MatthewATaylor/DigiDrum3000/pcb/pcb.kicad_pcb

## KiCad design pcb/pcb.kicad_pcb (2025-11-11)

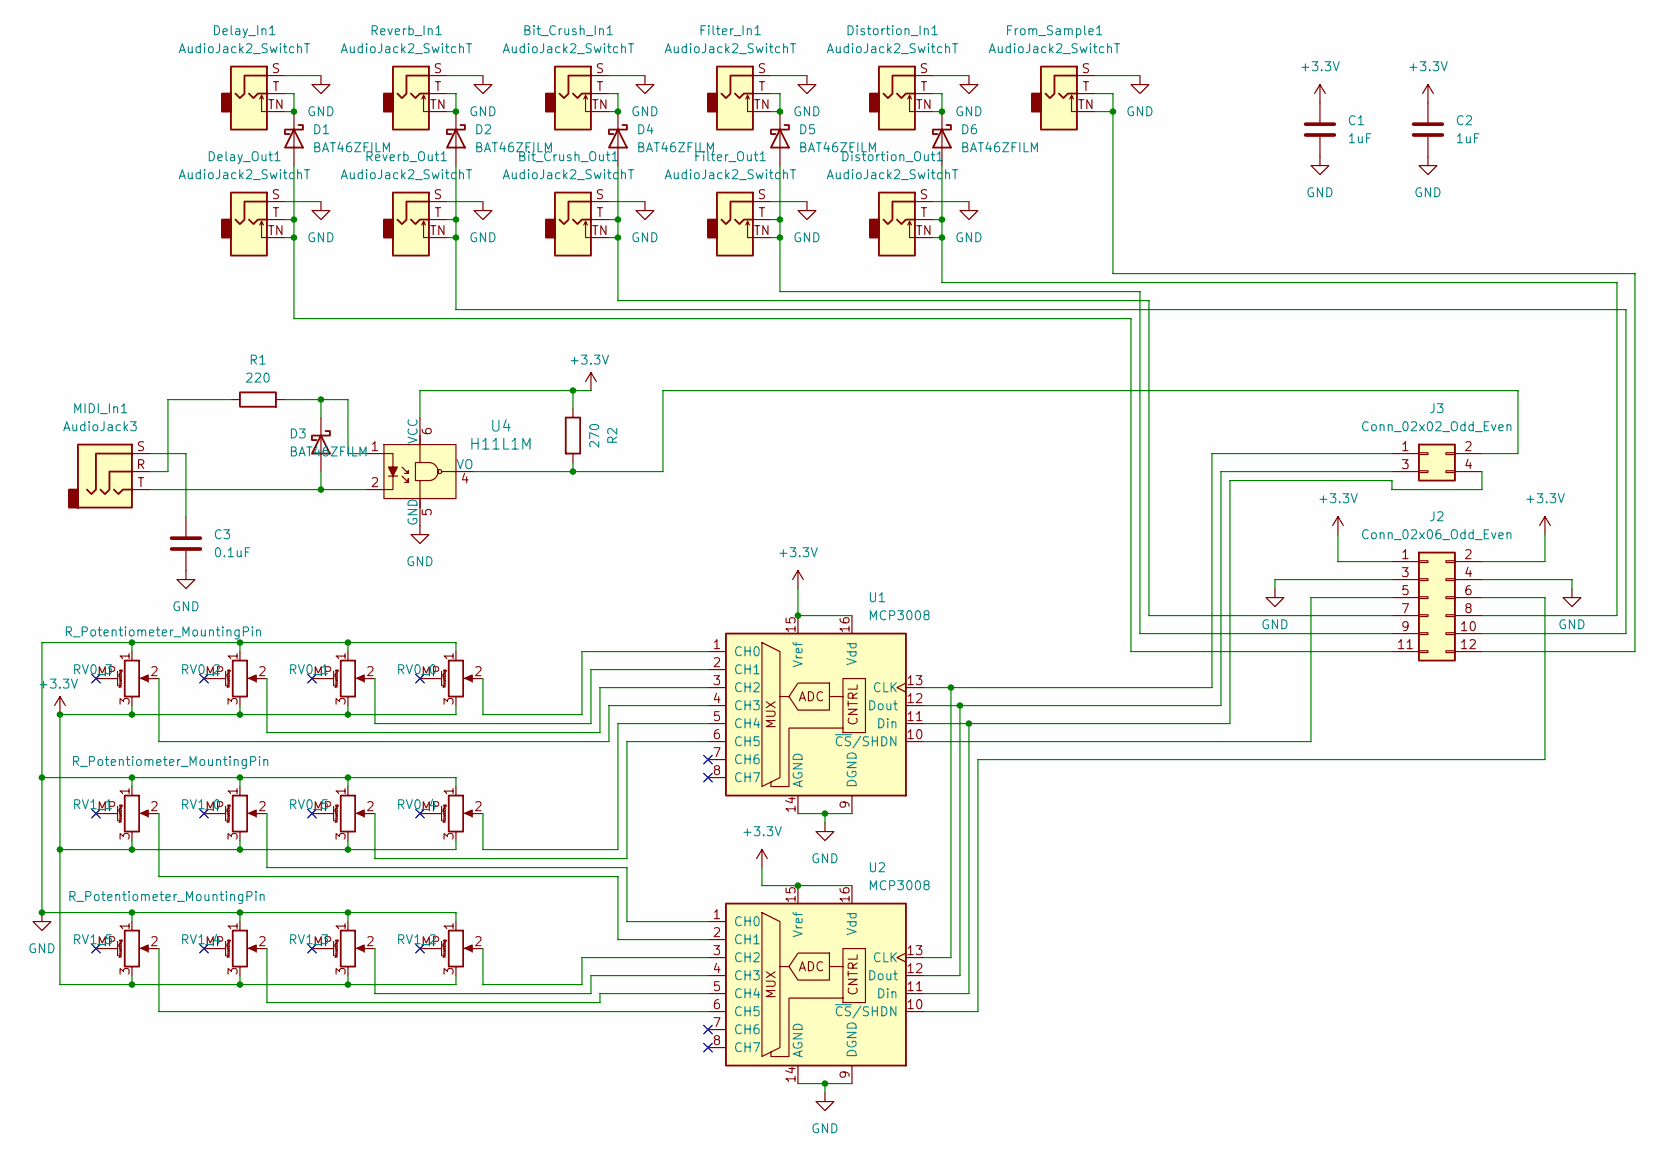
[picture p1: schematic pcb.kicad_sch, Drum Machine PCB]

Parts:
Bit_Crush_In1: AudioJack2_SwitchT; Jack_3.5mm_QingPu_WQP-PJ398SM_Vertical_CircularHoles
Bit_Crush_Out1: AudioJack2_SwitchT; Jack_3.5mm_QingPu_WQP-PJ398SM_Vertical_CircularHoles
C1, C2: 1uF; 0805
C3: 0.1uF; 0805
D1, D2, D3, D4, D5, D6: BAT46ZFILM; D_SOD-123
Delay_In1: AudioJack2_SwitchT; Jack_3.5mm_QingPu_WQP-PJ398SM_Vertical_CircularHoles
Delay_Out1: AudioJack2_SwitchT; Jack_3.5mm_QingPu_WQP-PJ398SM_Vertical_CircularHoles
Distortion_In1: AudioJack2_SwitchT; Jack_3.5mm_QingPu_WQP-PJ398SM_Vertical_CircularHoles
Distortion_Out1: AudioJack2_SwitchT; Jack_3.5mm_QingPu_WQP-PJ398SM_Vertical_CircularHoles
Filter_In1: AudioJack2_SwitchT; Jack_3.5mm_QingPu_WQP-PJ398SM_Vertical_CircularHoles
Filter_Out1: AudioJack2_SwitchT; Jack_3.5mm_QingPu_WQP-PJ398SM_Vertical_CircularHoles
From_Sample1: AudioJack2_SwitchT; Jack_3.5mm_QingPu_WQP-PJ398SM_Vertical_CircularHoles
J2: Conn_02x06_Odd_Even; PinHeader_2x06_P2.54mm_Horizontal
J3: Conn_02x02_Odd_Even; PinHeader_2x02_P2.54mm_Horizontal
MIDI_In1: AudioJack3; Jack_3.5mm_QingPu_WQP-PJ366ST_Vertical_CircularHoles
R1: 220; 0805
R2: 270; 0805
RV0_0, RV0_1, RV0_2, RV0_3, RV0_4, RV0_5, RV1_0, RV1_1, RV1_2, RV1_3, RV1_4, RV1_5: R_Potentiometer_MountingPin; Potentiometer_Alpha_RD901F-40-00D_Single_Vertical_MP
Reverb_In1: AudioJack2_SwitchT; Jack_3.5mm_QingPu_WQP-PJ398SM_Vertical_CircularHoles
Reverb_Out1: AudioJack2_SwitchT; Jack_3.5mm_QingPu_WQP-PJ398SM_Vertical_CircularHoles
U1, U2: MCP3008; SOIC-16_W3.90mm
U4: H11L1M; DIP-6_W7.62mm; MPN H11L1M; Digi-Key_PN H11L1-MQT-ND

Connections:
+3.3V: C1.1, C2.1, J2.1, J2.2, R2.1, RV0_0.3, RV0_1.3, RV0_2.3, RV0_3.3, RV0_4.3, RV0_5.3, RV1_0.3, RV1_1.3, RV1_2.3, RV1_3.3, RV1_4.3, RV1_5.3, U1.15 (Vref), U1.16 (Vdd), U2.15 (Vref), U2.16 (Vdd), U4.6 (VCC)
GND: Bit_Crush_In1.S, Bit_Crush_Out1.S, C1.2, C2.2, C3.2, Delay_In1.S, Delay_Out1.S, Distortion_In1.S, Distortion_Out1.S, Filter_In1.S, Filter_Out1.S, From_Sample1.S, J2.3, J2.4, RV0_0.1, RV0_1.1, RV0_2.1, RV0_3.1, RV0_4.1, RV0_5.1, RV1_0.1, RV1_1.1, RV1_2.1, RV1_3.1, RV1_4.1, RV1_5.1, Reverb_In1.S, Reverb_Out1.S, U1.9 (DGND), U1.14 (AGND), U2.9 (DGND), U2.14 (AGND), U4.5 (GND)
unnamed: C3.1, MIDI_In1.S
unnamed: D1.2 (A), Delay_Out1.T, Delay_Out1.TN, J2.11
unnamed: D1.1 (K), Delay_In1.T, Delay_In1.TN
unnamed: D2.2 (A), J2.10, Reverb_Out1.T, Reverb_Out1.TN
unnamed: D2.1 (K), Reverb_In1.T, Reverb_In1.TN
unnamed: D3.2 (A), MIDI_In1.T, U4.2
unnamed: D3.1 (K), R1.2, U4.1
unnamed: Bit_Crush_Out1.T, Bit_Crush_Out1.TN, D4.2 (A), J2.7
unnamed: Bit_Crush_In1.T, Bit_Crush_In1.TN, D4.1 (K)
unnamed: D5.2 (A), Filter_Out1.T, Filter_Out1.TN, J2.9
unnamed: D5.1 (K), Filter_In1.T, Filter_In1.TN
unnamed: D6.2 (A), Distortion_Out1.T, Distortion_Out1.TN, J2.8
unnamed: D6.1 (K), Distortion_In1.T, Distortion_In1.TN
unnamed: J2.5, U1.10 (~CS/SHDN)
unnamed: J2.6, U2.10 (~CS/SHDN)
unnamed: From_Sample1.T, From_Sample1.TN, J2.12
unnamed: J3.1, U1.13 (CLK), U2.13 (CLK)
unnamed: J3.2, R2.2, U4.4 (VO)
unnamed: J3.3, U1.12 (Dout), U2.12 (Dout)
unnamed: J3.4, U1.11 (Din), U2.11 (Din)
unnamed: MIDI_In1.R, R1.1
unnamed: RV0_0.2, U1.1 (CH0)
unnamed: RV0_1.2, U1.2 (CH1)
unnamed: RV0_2.2, U1.3 (CH2)
unnamed: RV0_3.2, U1.4 (CH3)
unnamed: RV0_4.2, U1.5 (CH4)
unnamed: RV0_5.2, U1.6 (CH5)
unnamed: RV1_0.2, U2.1 (CH0)
unnamed: RV1_1.2, U2.2 (CH1)
unnamed: RV1_2.2, U2.3 (CH2)
unnamed: RV1_3.2, U2.4 (CH3)
unnamed: RV1_4.2, U2.5 (CH4)
unnamed: RV1_5.2, U2.6 (CH5)

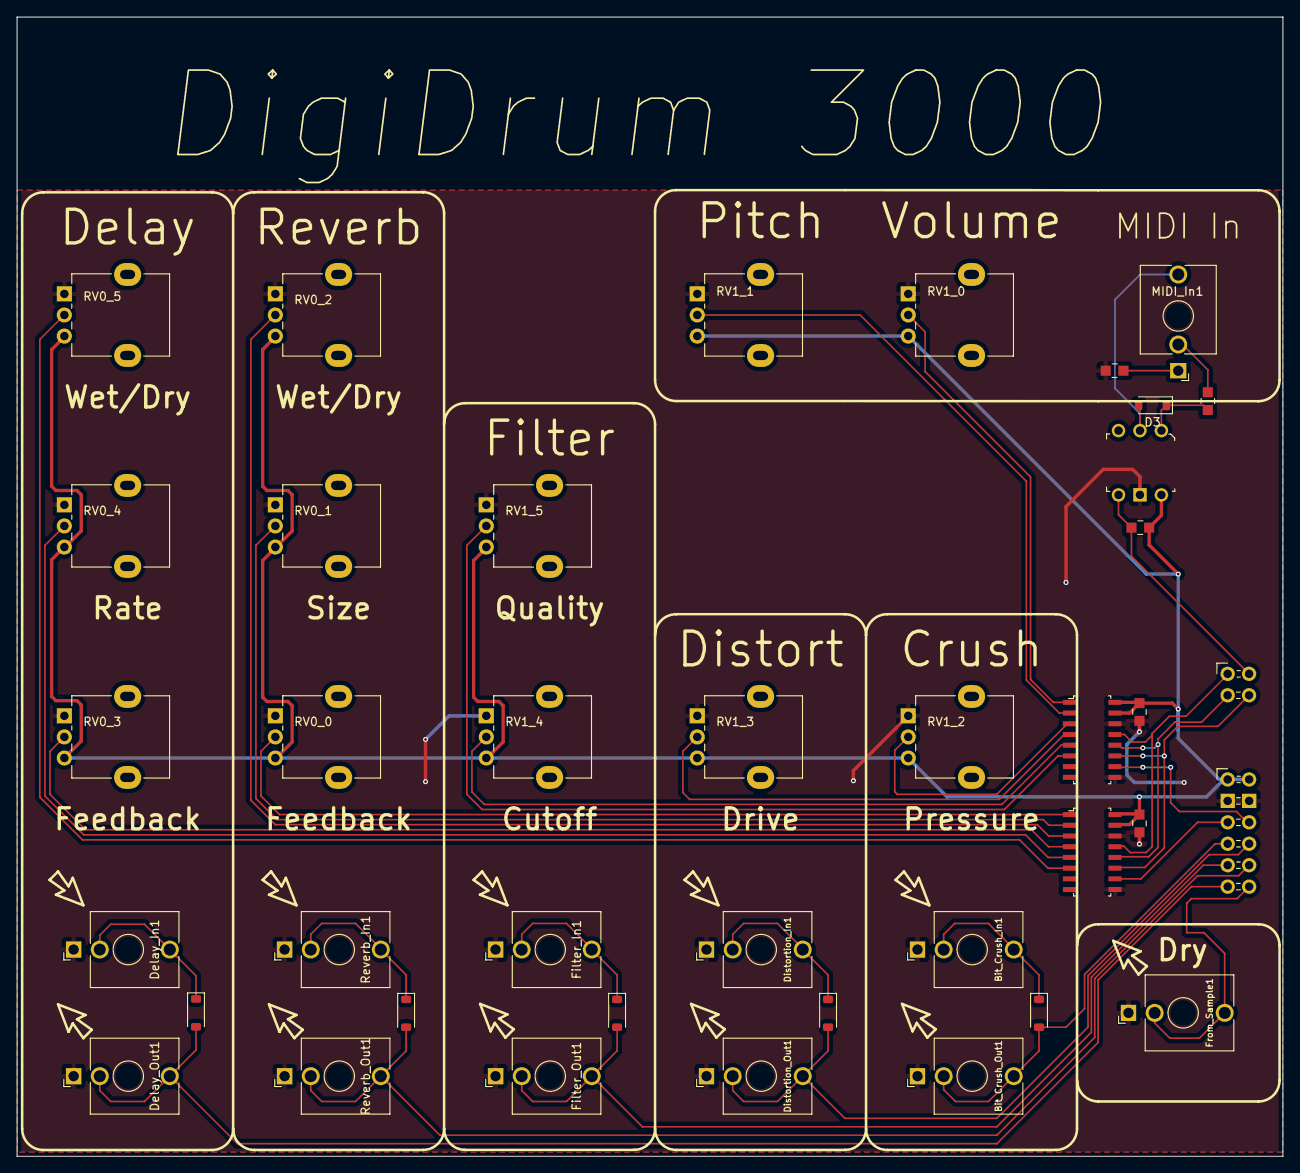
[picture p2: board pcb.kicad_pcb from above]

Board: 2 copper layers, 150.0 x 135.0 mm, 40 parts (0 on the bottom side), 35 nets.
