MatthewATaylor/DigiDrum3000/hdl/video_processor.sv

`timescale 1ns / 1ps  //
`default_nettype none

module video_processor #(
    parameter INSTRUMENT_COUNT = 3
) (
    input wire clk_100MHz,
    input wire clk_pixel,
    input wire rst,

    // clk_100MHz
    //input wire [15:0] instrument_samples[INSTRUMENT_COUNT-1:0],
    input wire midi_valid,
    input wire [6:0] midi_key,
    input wire [6:0] midi_velocity,
    //input wire [15:0] upsampled_audio_ouput,
    input wire [9:0] volume_on_clk,
    input wire [9:0] pitch_on_clk,
    input wire [9:0] delay_wet_on_clk,
    input wire [9:0] delay_rate_on_clk,
    input wire [9:0] delay_feedback_on_clk,
    input wire [9:0] reverb_wet_on_clk,
    input wire [9:0] reverb_size_on_clk,
    input wire [9:0] reverb_feedback_on_clk,
    input wire [9:0] filter_quality_on_clk,
    input wire [9:0] filter_cutoff_on_clk,
    input wire [9:0] distortion_drive_on_clk,
    input wire [9:0] crush_pressure_on_clk,

    input wire [2:0] output_src_on_clk,
    input wire [2:0] crush_src_on_clk,
    input wire [2:0] distortion_src_on_clk,
    input wire [2:0] filter_src_on_clk,
    input wire [2:0] reverb_src_on_clk,
    input wire [2:0] delay_src_on_clk,

    input wire delay_rate_fast_on_clk,

    // clk_pixel
    input  wire  [15:0] dram_read_data,
    output logic        dram_read_active_draw,
    output logic [10:0] dram_read_h_count,
    output logic [ 9:0] dram_read_v_count,

    output logic [15:0] dram_write_data,
    output logic        dram_write_valid,
    output logic        dram_write_last,

    output logic [23:0] pixel_to_hdmi,
    output logic        active_draw_to_hdmi,
    output logic        v_sync_to_hdmi,
    output logic        h_sync_to_hdmi
);
  logic [ 9:0] volume_on_pixel_clk;
  logic [ 9:0] pitch_on_pixel_clk;
  logic [ 9:0] delay_wet_on_pixel_clk;
  logic [ 9:0] delay_rate_on_pixel_clk;
  logic [ 9:0] delay_feedback_on_pixel_clk;
  logic [ 9:0] reverb_wet_on_pixel_clk;
  logic [ 9:0] reverb_size_on_pixel_clk;
  logic [ 9:0] reverb_feedback_on_pixel_clk;
  logic [ 9:0] filter_quality_on_pixel_clk;
  logic [ 9:0] filter_cutoff_on_pixel_clk;
  logic [ 9:0] distortion_drive_on_pixel_clk;
  logic [ 9:0] crush_pressure_on_pixel_clk;

  logic [ 2:0] output_src_on_pixel_clk;
  logic [ 2:0] crush_src_on_pixel_clk;
  logic [ 2:0] distortion_src_on_pixel_clk;
  logic [ 2:0] filter_src_on_pixel_clk;
  logic [ 2:0] reverb_src_on_pixel_clk;
  logic [ 2:0] delay_src_on_pixel_clk;

  logic        delay_rate_fast_on_pixel_clk;

  logic [10:0] sig_gen_h_count;
  logic [ 9:0] sig_gen_v_count;
  logic        sig_gen_active_draw;
  logic        sig_gen_new_frame;

  clk_cross_buffer my_buf (
      .clk_pixel(clk_pixel),
      .rst      (rst),
      .new_frame(sig_gen_new_frame),

      .volume_on_clk          (volume_on_clk),
      .pitch_on_clk           (pitch_on_clk),
      .delay_wet_on_clk       (delay_wet_on_clk),
      .delay_rate_on_clk      (delay_rate_on_clk),
      .delay_feedback_on_clk  (delay_feedback_on_clk),
      .reverb_wet_on_clk      (reverb_wet_on_clk),
      .reverb_size_on_clk     (reverb_size_on_clk),
      .reverb_feedback_on_clk (reverb_feedback_on_clk),
      .filter_quality_on_clk  (filter_quality_on_clk),
      .filter_cutoff_on_clk   (filter_cutoff_on_clk),
      .distortion_drive_on_clk(distortion_drive_on_clk),
      .crush_pressure_on_clk  (crush_pressure_on_clk),

      .output_src_on_clk    (output_src_on_clk),
      .crush_src_on_clk     (crush_src_on_clk),
      .distortion_src_on_clk(distortion_src_on_clk),
      .filter_src_on_clk    (filter_src_on_clk),
      .reverb_src_on_clk    (reverb_src_on_clk),
      .delay_src_on_clk     (delay_src_on_clk),

      .delay_rate_fast_on_clk(delay_rate_fast_on_clk),

      .volume_on_pixel_clk          (volume_on_pixel_clk),
      .pitch_on_pixel_clk           (pitch_on_pixel_clk),
      .delay_wet_on_pixel_clk       (delay_wet_on_pixel_clk),
      .delay_rate_on_pixel_clk      (delay_rate_on_pixel_clk),
      .delay_feedback_on_pixel_clk  (delay_feedback_on_pixel_clk),
      .reverb_wet_on_pixel_clk      (reverb_wet_on_pixel_clk),
      .reverb_size_on_pixel_clk     (reverb_size_on_pixel_clk),
      .reverb_feedback_on_pixel_clk (reverb_feedback_on_pixel_clk),
      .filter_quality_on_pixel_clk  (filter_quality_on_pixel_clk),
      .filter_cutoff_on_pixel_clk   (filter_cutoff_on_pixel_clk),
      .distortion_drive_on_pixel_clk(distortion_drive_on_pixel_clk),
      .crush_pressure_on_pixel_clk  (crush_pressure_on_pixel_clk),

      .output_src_on_pixel_clk    (output_src_on_pixel_clk),
      .crush_src_on_pixel_clk     (crush_src_on_pixel_clk),
      .distortion_src_on_pixel_clk(distortion_src_on_pixel_clk),
      .filter_src_on_pixel_clk    (filter_src_on_pixel_clk),
      .reverb_src_on_pixel_clk    (reverb_src_on_pixel_clk),
      .delay_src_on_pixel_clk     (delay_src_on_pixel_clk),

      .delay_rate_fast_on_pixel_clk(delay_rate_fast_on_pixel_clk)
  );

  video_sig_gen_basic my_sig_gen (
      .clk(clk_pixel),
      .rst(rst),

      .h_count(sig_gen_h_count),
      .v_count(sig_gen_v_count),
      .active_draw(sig_gen_active_draw),
      .new_frame(sig_gen_new_frame)
  );

  logic [10:0] sig_gen_h_count_comp;
  logic [ 9:0] sig_gen_v_count_comp;
  logic        sig_gen_active_draw_comp;

  video_delay_compinsator(
      .clk(clk_pixel),
      .rst(rst),

      .h_count_in(sig_gen_h_count),
      .v_count_in(sig_gen_v_count),
      .active_draw_in(sig_gen_active_draw),

      .crush_src(crush_src_on_pixel_clk),
      .distortion_src(distortion_src_on_pixel_clk),
      .filter_src(filter_src_on_pixel_clk),
      .reverb_src(reverb_src_on_pixel_clk),

      .h_count_out(sig_gen_h_count_comp),
      .v_count_out(sig_gen_v_count_comp),
      .active_draw_out(sig_gen_active_draw_comp)
  );

  logic [7:0] inst_intensity[INSTRUMENT_COUNT-1:0];
  note_tracker_midi #(
      .INSTRUMENT_COUNT(INSTRUMENT_COUNT)
  ) my_note_tracker (
      .clk_100MHz(clk_100MHz),
      .clk_pixel(clk_pixel),
      .rst(rst),

      .midi_key(midi_key),
      .midi_valid(midi_valid),
      .midi_velocity(midi_velocity),
      .pitch(pitch_on_pixel_clk),

      .new_frame(sig_gen_new_frame),
      .inst_intensity(inst_intensity)
  );

  logic [7:0] dry_intensity;
  logic [7:0] dry_intensity_pipe[2:0];
  logic [7:0] delay_intensity;

  dry_gen my_dry_gen (
      .clk(clk_pixel),
      .rst(rst),

      .active_draw(sig_gen_active_draw_comp),
      .h_count(sig_gen_h_count_comp),
      .v_count(sig_gen_v_count_comp),
      .inst_intensity(inst_intensity),

      .intensity(dry_intensity)
  );

  delay_gen my_delay_gen (
      .clk(clk_pixel),
      .rst(rst),

      .active_draw(sig_gen_active_draw_comp),
      .h_count(sig_gen_h_count_comp),
      .v_count(sig_gen_v_count_comp),
      .inst_intensity(inst_intensity),

      .wet(delay_wet_on_pixel_clk),
      .rate(delay_rate_on_pixel_clk),
      .feedback(delay_feedback_on_pixel_clk),
      .rate_fast(delay_rate_fast_on_pixel_clk),

      .intensity(delay_intensity)
  );

  logic [23:0] pixel_color_from_color_gen;

  color_gen my_color (
      .clk(clk_pixel),
      .rst(rst),

      .h_count(sig_gen_h_count_comp),
      .v_count(sig_gen_v_count_comp),
      .pitch  (pitch_on_pixel_clk),

      .color(pixel_color_from_color_gen)
  );

  localparam BASE_GEN_PIPE_LENGTH = 7;
  logic [10:0] base_h_count_pipe[BASE_GEN_PIPE_LENGTH-1:0];
  logic [ 9:0] base_v_count_pipe[BASE_GEN_PIPE_LENGTH-1:0];

  always_ff @(posedge clk_pixel) begin
    if (rst) begin
      dry_intensity_pipe[0] <= 0;
      dry_intensity_pipe[1] <= 0;
      dry_intensity_pipe[2] <= 0;
      for (integer i = 0; i < BASE_GEN_PIPE_LENGTH; i += 1) begin
        base_h_count_pipe[i+1] <= 0;
        base_v_count_pipe[i+1] <= 0;
      end
    end else begin
      dry_intensity_pipe[0] <= dry_intensity;
      dry_intensity_pipe[1] <= dry_intensity_pipe[0];
      dry_intensity_pipe[2] <= dry_intensity_pipe[1];
      base_h_count_pipe[0]  <= sig_gen_h_count_comp;
      base_v_count_pipe[0]  <= sig_gen_v_count_comp;
      for (integer i = 0; i < BASE_GEN_PIPE_LENGTH - 1; i += 1) begin
        base_h_count_pipe[i+1] <= base_h_count_pipe[i];
        base_v_count_pipe[i+1] <= base_v_count_pipe[i];
      end
    end
  end

  logic [10:0] h_count_base;
  logic [ 9:0] v_count_base;
  logic        active_draw_base;
  logic [23:0] pixel_base;

  logic [10:0] h_count_from_crush;
  logic [ 9:0] v_count_from_crush;
  logic        active_draw_from_crush;
  logic [23:0] pixel_from_crush;

  logic [10:0] h_count_from_distortion;
  logic [ 9:0] v_count_from_distortion;
  logic        active_draw_from_distortion;
  logic [23:0] pixel_from_distortion;

  logic [10:0] h_count_from_filter;
  logic [ 9:0] v_count_from_filter;
  logic        active_draw_from_filter;
  logic [23:0] pixel_from_filter;

  logic [10:0] h_count_from_reverb;
  logic [ 9:0] v_count_from_reverb;
  logic        active_draw_from_reverb;
  logic [23:0] pixel_from_reverb;

  logic [10:0] h_count_to_crush;
  logic [ 9:0] v_count_to_crush;
  logic        active_draw_to_crush;
  logic [23:0] pixel_to_crush;

  logic [10:0] h_count_to_distortion;
  logic [ 9:0] v_count_to_distortion;
  logic        active_draw_to_distortion;
  logic [23:0] pixel_to_distortion;

  logic [10:0] h_count_to_filter;
  logic [ 9:0] v_count_to_filter;
  logic        active_draw_to_filter;
  logic [23:0] pixel_to_filter;

  logic [10:0] h_count_to_reverb;
  logic [ 9:0] v_count_to_reverb;
  logic        active_draw_to_reverb;
  logic [23:0] pixel_to_reverb;

  logic [10:0] h_count_output;
  logic [ 9:0] v_count_output;
  logic        active_draw_output;
  logic [23:0] pixel_output;

  video_multi_mux(
      .clk(clk_pixel),
      .rst(rst),

      .delay_src(delay_src_on_pixel_clk),
      .output_src(output_src_on_pixel_clk),
      .crush_src(crush_src_on_pixel_clk),
      .distortion_src(distortion_src_on_pixel_clk),
      .filter_src(filter_src_on_pixel_clk),
      .reverb_src(reverb_src_on_pixel_clk),

      .h_count_from_base(h_count_base),
      .v_count_from_base(v_count_base),
      .active_draw_from_base(active_draw_base),
      .pixel_from_base(pixel_base),

      .h_count_from_crush(h_count_from_crush),
      .v_count_from_crush(v_count_from_crush),
      .active_draw_from_crush(active_draw_from_crush),
      .pixel_from_crush(pixel_from_crush),

      .h_count_from_distortion(h_count_from_distortion),
      .v_count_from_distortion(v_count_from_distortion),
      .active_draw_from_distortion(active_draw_from_distortion),
      .pixel_from_distortion(pixel_from_distortion),

      .h_count_from_filter(h_count_from_filter),
      .v_count_from_filter(v_count_from_filter),
      .active_draw_from_filter(active_draw_from_filter),
      .pixel_from_filter(pixel_from_filter),

      .h_count_from_reverb(h_count_from_reverb),
      .v_count_from_reverb(v_count_from_reverb),
      .active_draw_from_reverb(active_draw_from_reverb),
      .pixel_from_reverb(pixel_from_reverb),

      .h_count_to_crush(h_count_to_crush),
      .v_count_to_crush(v_count_to_crush),
      .active_draw_to_crush(active_draw_to_crush),
      .pixel_to_crush(pixel_to_crush),

      .h_count_to_distortion(h_count_to_distortion),
      .v_count_to_distortion(v_count_to_distortion),
      .active_draw_to_distortion(active_draw_to_distortion),
      .pixel_to_distortion(pixel_to_distortion),

      .h_count_to_filter(h_count_to_filter),
      .v_count_to_filter(v_count_to_filter),
      .active_draw_to_filter(active_draw_to_filter),
      .pixel_to_filter(pixel_to_filter),

      .h_count_to_reverb(h_count_to_reverb),
      .v_count_to_reverb(v_count_to_reverb),
      .active_draw_to_reverb(active_draw_to_reverb),
      .pixel_to_reverb(pixel_to_reverb),

      .h_count_to_output(h_count_output),
      .v_count_to_output(v_count_output),
      .active_draw_to_output(active_draw_output),
      .pixel_to_output(pixel_output)
  );

  video_crush my_crush (
      .clk(clk_pixel),
      .rst(rst),

      .h_count_in(h_count_to_crush),
      .v_count_in(v_count_to_crush),
      .active_draw_in(active_draw_to_crush),
      .pixel_in(pixel_to_crush),
      .pressure(crush_pressure_on_pixel_clk),

      .h_count_out(h_count_from_crush),
      .v_count_out(v_count_from_crush),
      .active_draw_out(active_draw_from_crush),
      .pixel_out(pixel_from_crush)
  );

  video_distortion my_distortion (
      .clk(clk_pixel),
      .rst(rst),

      .h_count_in(h_count_to_distortion),
      .v_count_in(v_count_to_distortion),
      .active_draw_in(active_draw_to_distortion),
      .pixel_in(pixel_to_distortion),
      .drive(distortion_drive_on_pixel_clk),

      .h_count_out(h_count_from_distortion),
      .v_count_out(v_count_from_distortion),
      .active_draw_out(active_draw_from_distortion),
      .pixel_out(pixel_from_distortion)
  );

  video_filter my_filter (
      .clk(clk_pixel),
      .rst(rst),

      .h_count_in(h_count_to_filter),
      .v_count_in(v_count_to_filter),
      .active_draw_in(active_draw_to_filter),
      .pixel_in(pixel_to_filter),

      .cutoff (filter_cutoff_on_pixel_clk),
      .quality(filter_quality_on_pixel_clk),

      .h_count_out(h_count_from_filter),
      .v_count_out(v_count_from_filter),
      .active_draw_out(active_draw_from_filter),
      .pixel_out(pixel_from_filter)
  );

  video_reverb my_reverb (
      .clk(clk_pixel),
      .rst(rst),

      .h_count_in(h_count_to_reverb),
      .v_count_in(v_count_to_reverb),
      .active_draw_in(active_draw_to_reverb),
      .pixel_in(pixel_to_reverb),

      .wet(reverb_wet_on_pixel_clk),
      .feedback(reverb_feedback_on_pixel_clk),
      .size(reverb_size_on_pixel_clk),

      .h_count_out(h_count_from_reverb),
      .v_count_out(v_count_from_reverb),
      .active_draw_out(active_draw_from_reverb),
      .pixel_out(pixel_from_reverb),

      .dram_read_data(dram_read_data),
      .dram_read_h_count(dram_read_h_count),
      .dram_read_v_count(dram_read_v_count),
      .dram_read_active_draw(dram_read_active_draw),

      .dram_write_data (dram_write_data),
      .dram_write_valid(dram_write_valid),
      .dram_write_tlast(dram_write_last)
  );

  base_combiner my_combiner (
      .clk(clk_pixel),
      .rst(rst),
      .h_count_in(base_h_count_pipe[BASE_GEN_PIPE_LENGTH-1]),
      .v_count_in(base_v_count_pipe[BASE_GEN_PIPE_LENGTH-1]),
      .brightness_from_dry(dry_intensity_pipe[2]),
      .brightness_from_delay(delay_intensity),
      .pixel_color_in(pixel_color_from_color_gen),
      .delay_src(delay_src_on_pixel_clk),

      .h_count_out(h_count_base),
      .v_count_out(v_count_base),
      .active_draw_out(active_draw_base),
      .pixel_color_out(pixel_base)
  );

  gui_render_and_overlay my_gui (
      .clk(clk_pixel),
      .rst(rst),
      .h_count_in(sig_gen_h_count),
      .v_count_in(sig_gen_v_count),
      .pixel_in(pixel_output),
      .active_draw_in(sig_gen_active_draw),

      .pixel_to_hdmi(pixel_to_hdmi),
      .h_sync_to_hdmi(h_sync_to_hdmi),
      .v_sync_to_hdmi(v_sync_to_hdmi),
      .active_draw_to_hdmi(active_draw_to_hdmi)
  );

endmodule

`default_nettype wire
