MatthewATaylor/DigiDrum3000/hdl/cw_dram_eth.v

// (c) Copyright 2017-2018, 2023 Advanced Micro Devices, Inc. All rights reserved.
//
// This file contains confidential and proprietary information
// of AMD and is protected under U.S. and international copyright
// and other intellectual property laws.
//
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
// CRITICAL APPLICATIONS
// AMD products are not designed or intended to be fail-
// safe, or for use in any application requiring fail-safe
// performance, such as life-support or safety devices or
// systems, Class III medical devices, nuclear facilities,
// applications related to the deployment of airbags, or any
// other applications that could lead to death, personal
// injury, or severe property or environmental damage
// (individually and collectively, "Critical
// Applications"). Customer assumes the sole risk and
// liability of any use of AMD products in Critical
// Applications, subject only to applicable laws and
// regulations governing limitations on product liability.
//
// THIS COPYRIGHT NOTICE AND DISCLAIMER MUST BE RETAINED AS
// PART OF THIS FILE AT ALL TIMES.

`timescale 1ps/1ps

module cw_dram_eth

 (
  input         clk_in,        // 100 MHz
  input         reset,
  output        locked,
  output        clk_dram_ref,  // 200 MHz
  output        eth_clk,       // 50 MHz
  output        clk_audio      // 120 MHz
 );

  // Clocking PRIMITIVE
  //------------------------------------

  // Instantiation of the MMCM PRIMITIVE
  //    * Unused inputs are tied off
  //    * Unused outputs are labeled unused

  wire        clk_dram_ref_prebuf;
  wire        eth_clk_prebuf;
  wire        clk_audio_prebuf;

  wire [15:0] do_unused;
  wire        drdy_unused;
  wire        psdone_unused;
  wire        locked_int;
  wire        clkfbout_prebuf;
  wire        clkfbout;
  wire        clkfboutb_unused;
  wire        clkout0_unused;
  wire        clkout0b_unused;
  wire        clkout1b_unused;
  wire        clkout2b_unused;
  wire        clkout3_unused;
  wire        clkout3b_unused;
  wire        clkout4_unused;
  wire        clkout5_unused;
  wire        clkout6_unused;
  wire        clkfbstopped_unused;
  wire        clkinstopped_unused;
  wire        reset_high;

  MMCME2_ADV
  #(.BANDWIDTH            ("OPTIMIZED"),
    .CLKOUT4_CASCADE      ("FALSE"),
    .COMPENSATION         ("ZHOLD"),
    .STARTUP_WAIT         ("FALSE"),
    .DIVCLK_DIVIDE        (1),
    .CLKFBOUT_MULT_F      (6.000),
    .CLKFBOUT_PHASE       (0.000),
    .CLKFBOUT_USE_FINE_PS ("FALSE"),
    .CLKOUT1_DIVIDE       (3),
    .CLKOUT1_PHASE        (0.000),
    .CLKOUT1_DUTY_CYCLE   (0.500),
    .CLKOUT1_USE_FINE_PS  ("FALSE"),
    .CLKOUT2_DIVIDE       (12),
    .CLKOUT2_PHASE        (0.000),
    .CLKOUT2_DUTY_CYCLE   (0.500),
    .CLKOUT2_USE_FINE_PS  ("FALSE"),
    .CLKOUT3_DIVIDE       (5),
    .CLKOUT3_PHASE        (0.000),
    .CLKOUT3_DUTY_CYCLE   (0.500),
    .CLKOUT3_USE_FINE_PS  ("FALSE"),
    .CLKIN1_PERIOD        (10.000))
  mmcm_adv_inst
    // Output clocks
   (
    .CLKFBOUT            (clkfbout_prebuf),
    .CLKFBOUTB           (clkfboutb_unused),
    .CLKOUT0             (clkout0_unused),
    .CLKOUT0B            (clkout0b_unused),
    .CLKOUT1             (clk_dram_ref_prebuf),
    .CLKOUT1B            (clkout1b_unused),
    .CLKOUT2             (eth_clk_prebuf),
    .CLKOUT2B            (clkout2b_unused),
    .CLKOUT3             (clk_audio_prebuf),
    .CLKOUT3B            (clkout3b_unused),
    .CLKOUT4             (clkout4_unused),
    .CLKOUT5             (clkout5_unused),
    .CLKOUT6             (clkout6_unused),
     // Input clock control
    .CLKFBIN             (clkfbout),
    .CLKIN1              (clk_in),
    .CLKIN2              (1'b0),
     // Tied to always select the primary input clock
    .CLKINSEL            (1'b1),
    // Ports for dynamic reconfiguration
    .DADDR               (7'h0),
    .DCLK                (1'b0),
    .DEN                 (1'b0),
    .DI                  (16'h0),
    .DO                  (do_unused),
    .DRDY                (drdy_unused),
    .DWE                 (1'b0),
    // Ports for dynamic phase shift
    .PSCLK               (1'b0),
    .PSEN                (1'b0),
    .PSINCDEC            (1'b0),
    .PSDONE              (psdone_unused),
    // Other control and status signals
    .LOCKED              (locked_int),
    .CLKINSTOPPED        (clkinstopped_unused),
    .CLKFBSTOPPED        (clkfbstopped_unused),
    .PWRDWN              (1'b0),
    .RST                 (reset_high));
  assign reset_high = reset;

  assign locked = locked_int;
// Clock Monitor clock assigning
//--------------------------------------
 // Output buffering
  //-----------------------------------

  BUFG clkfbout_buf
   (.O   (clkfbout),
    .I   (clkfbout_prebuf));

  BUFG clk_dram_ref_buf
   (.O   (clk_dram_ref),
    .I   (clk_dram_ref_prebuf));

  BUFG eth_clk_buf
   (.O   (eth_clk),
    .I   (eth_clk_prebuf));

  BUFG clk_audio_buf
   (.O   (clk_audio),
    .I   (clk_audio_prebuf));

endmodule
