MatthewATaylor/DigiDrum3000/hdl/downsampler.sv

`timescale 1ns / 1ps
`default_nettype none

`ifdef SYNTHESIS
`define FPATH(X) `"X`"
`else  /* ! SYNTHESIS */
`define FPATH(X) `"../data/X`"
`endif  /* ! SYNTHESIS */

// Polyphase 4:1 downsampler
module downsampler
    (
        input  wire         clk,
        input  wire         rst,
        input  wire  [15:0] sample_in,
        input  wire         sample_in_valid,  // Expects valid every 2500/4 clock cycles
        output logic [15:0] sample_out,
        output logic        sample_out_valid
    );

    localparam TAPS = 512;
    localparam BANKS = TAPS/4;
    localparam BUFFER_DEPTH = TAPS;
    
    logic [$clog2(TAPS)-1:0]  buf_addr;
    logic                     buf_we;
    logic [15:0]              buf_din;
    logic [15:0]              buf_dout;
    logic [$clog2(TAPS)-1:0]  buf_start;

    logic [43:0]              accum;

    logic [1:0]               sample_in_counter;

    logic [$clog2(TAPS)-1:0]  filter_index;
    logic [17:0]              filter_data;

    logic [1:0]               coeff_counter;
    logic [$clog2(BANKS)-1:0] bank_counter;
    logic [$clog2(BANKS)-1:0] bank_counter_buf [2:0];


    // Filter computation

    logic is_computing;
    
    logic [33:0] product;
    assign product = $signed(filter_data) * $signed(buf_dout);

    always_ff @ (posedge clk) begin
        if (rst) begin
            is_computing <= 0;
            accum <= 0;
            sample_out_valid <= 0;
        end else begin
            if (!is_computing) begin
                if (bank_counter_buf[2] == 0) begin
                    is_computing <= 1;
                    if (sample_in_counter == 1) begin
                        accum <= $signed(product);
                    end else begin
                        accum <= $signed(accum) + $signed(product);
                    end
                end
            end else begin
                if (bank_counter_buf[2] == BANKS-1) begin
                    is_computing <= 0;
                    if (sample_in_counter == 0) begin
                        sample_out_valid <= 1;
                    end
                end
                accum <= $signed(accum) + $signed(product);
            end

            if (sample_out_valid) begin
                sample_out_valid <= 0;
            end
        end
    end


    // BRAM interfacing
   
    logic sample_in_valid_buf;

    logic [1:0] coeff_counter_inc;
    assign coeff_counter_inc = coeff_counter + 1;
    
    logic [9:0] bank_counter_x4;
    assign bank_counter_x4 = {2'b0, bank_counter} << 2;
    
    always_ff @ (posedge clk) begin
        if (rst) begin
            sample_in_valid_buf <= 0;

            sample_in_counter <= 0;
            buf_we <= 0;
            buf_din <= 0;
            buf_addr <= 0;
            buf_start <= 0;

            coeff_counter <= 0;
            filter_index <= 0;
            bank_counter <= 0;
            bank_counter_buf[0] <= 0;
            bank_counter_buf[1] <= 0;
            bank_counter_buf[2] <= 0;
        end else begin
            if (sample_in_valid) begin
                sample_in_counter <= sample_in_counter + 1;

                // Write new sample to buffer
                buf_we <= 1;
                buf_din <= sample_in;
                buf_addr <= buf_start - 1;
                buf_start <= buf_start - 1;

                // Cycle to next coefficient in each filter bank
                coeff_counter <= coeff_counter_inc;
                filter_index <= coeff_counter_inc;

                // Reset to first filter bank
                bank_counter <= 0;
            end else if (!sample_in_valid_buf) begin  // Delay for buffer write
                // Read next sample from buffer
                buf_we <= 0;
                buf_addr <= buf_start + bank_counter_x4;

                if (bank_counter < BANKS-1) begin
                    bank_counter <= bank_counter + 1;
                end
                filter_index <= coeff_counter + bank_counter_x4;
            end

            bank_counter_buf[0] <= bank_counter;
            bank_counter_buf[1] <= bank_counter_buf[0];
            bank_counter_buf[2] <= bank_counter_buf[1];

            sample_in_valid_buf <= sample_in_valid;
        end
    end


    // Output clipper
    always_comb begin
        if ($signed(accum[43:34]) < -3'sd1) begin
            sample_out = 16'h8000;
        end else if ($signed(accum[43:34]) > 3'sd0) begin
            sample_out = 16'h7FFF;
        end else begin
            sample_out = accum[34:19];
        end
    end


    // 2 cycle delay
    xilinx_single_port_ram_read_first #(
        .RAM_WIDTH(16),
        .RAM_DEPTH(TAPS),
        .RAM_PERFORMANCE("HIGH_PERFORMANCE"),
        .INIT_FILE("")
    ) sample_buffer_bram (
        .addra(buf_addr),
        .dina(buf_din),
        .clka(clk),
        .wea(buf_we),
        .ena(1),
        .rsta(rst),
        .regcea(1),
        .douta(buf_dout)
    );


    // 2 cycle delay
    xilinx_single_port_ram_read_first #(
        .RAM_WIDTH(18),
        .RAM_DEPTH(TAPS),
        .RAM_PERFORMANCE("HIGH_PERFORMANCE"),
        .INIT_FILE(
            `FPATH(x4_filter_coeffs.mem)
        )
    ) filter_bram (
        .addra(filter_index),
        .dina(0),
        .clka(clk),
        .wea(0),
        .ena(1),
        .rsta(rst),
        .regcea(1),
        .douta(filter_data)
    );

endmodule

`default_nettype wire
