MatthewATaylor/DigiDrum3000/(commit log)

2025-10-08 added testbench for delta-sigma dac, trying to debug 2nd order harmonic in sin_gen -> dlt_sig_dac_1st_order -> audio output on FPGA board
2025-10-10 changed DAC to drive between 0 and 0.5Vdd instead of 0 to Vdd, eliminated harmonic distortion (at least what's visible on occiliscope with -50dB noise floor)
    [dlt_sig_dac.sv, sig_gen.sv]
2025-10-10 measured response of analog filter on FPGA
2025-10-11 important note added: USE 2264 CYCLES PER SAMPLE
2025-10-11 designed minimum phase 1024 width lowpass filter for DAC upsampling
2025-10-13 updated filter stuff
2025-10-14 changed filter for 16x oversampling
2025-10-15 once again updated filter design
2025-10-15 first dac filter implimentation attempt, changing back filter encoding to make sense
2025-10-21 tested upsampler, has odd (assumed clipping related) bug at large values
    [DAC_filter_design.py, top_level.sv, upsampler.sv]
2025-10-22 started working on the pcb design
    [pcb.kicad_pcb, pcb.kicad_sch]
2025-10-23 completed circuit design
    [pcb.kicad_sch]
2025-10-23 added footprints to pcb and updated gitignore to include kicad.gitignore
    [pcb.kicad_sch]
2025-10-24 layed out pcb and adjusted design to meet Spartan 7 GPIO spec
    [pcb.kicad_pcb, pcb.kicad_sch]
2025-10-24 finished pretty-ing up pcb layout
    [pcb.kicad_pcb]
2025-10-24 updated pcb based on schottky diodes availible from lab on floor 5
    [pcb.kicad_pcb, pcb.kicad_sch]
2025-10-25 got testbench to match what I'm hearing in terms of noise
    [dlt_sig_dac.sv, top_level.sv]
2025-10-31 Fix video offset issue: properly initialize video logic and synchronize with DRAM output
    [dram_reader_video.sv, dram_writer.sv, sample_loader.sv, send_wav_short.py, stacker.sv, top_level.sv, traffic_generator.sv]
2025-10-31 finally implimented dither correctly
    [dlt_sig_dac.sv]
2025-11-02 add a hacky combinational pitch (potentiometer) to sample rate converter
2025-11-03 switched dry_gen to use direct sample peak rather than midi trigger
2025-11-07 Add Farrow resampler. Occasional glitches - need to rearrange operations.
    [resampler.sv, top_level.sv]
2025-11-07 updated note tracking to somewhat deprioritized very low frequencies (<60Hz)
2025-11-07 Track changes in sample_period for smoother resampling
2025-11-09 fixed my mistake THAT I COULD HAVE CAUGHT WITH DRC that seperates a trace from the pins by .1mm
    [pcb.kicad_pcb]
2025-11-09 made dry_pin pullup instead of true 1 to avoid shorts with ground when plugging in patch cables
    [pcb_interface.sv, top_level.sv, top_level.xdc]
2025-11-09 finished pcb interface
2025-11-15 Add some tests for tracking down audio crackle
    [resampler_and_upsampler.sv, send_wav.py, top_level.sv, upsampler.sv]
2025-11-15 Test sound of sample_period being held for 8 samples
2025-11-15 Fix crackling audio (store sample_period in memory command_fifo)
    [dram_read_requester.sv, dram_reader_audio.sv, instrument.sv, sample_mixer.sv, send_wav.py, top_level.sv, traffic_generator.sv]
2025-11-15 Remove sample period hold logic
2025-11-16 Fix some bit width warnings
    [audio_delay.sv, farrow_upsampler.sv, resampler.sv, top_level.sv]
2025-11-16 Add delay feedback and change controls for testing without PCB
2025-11-19 Switch to resampling audio delay
2025-11-20 Move downsampler sample buffer to BRAM
2025-11-21 Add fast/slow delay switch
2025-11-25 Add Python and SV ladder filters, but the SV one is very unrealistic right now
2025-11-25 Fix timing issues (upsampler, audio_filter)
    [IIR_design.py, top_level.sv, upsampler.sv]
2025-11-25 Forgot to reset a register
    [upsampler.sv]
2025-11-25 initial video filter implimentation
2025-11-29 Implement fixed point Freeverb
    [audio_reverb_design_fixed.py, freq_resp_z.py]
2025-12-02 added exponential calculator for use in video filter
2025-12-02 finished basic video filter
2025-12-03 Seems like adding registers at the audio outputs helps with noise a little?
    [top_level.sv, top_level.xdc]
2025-12-03 fixed gaussian coefficients to actually be gaussian
    [exponent.sv, video_filter.sv]
2025-12-05 Add velocity sensitivity, remove upsampler latch
2025-12-05 Was too stingy with filter optimization. Bringing back some bits.
2025-12-06 fixed display flickering/cutting out when changing patch
    [video_delay_compinsator.sv, video_processor.sv]
2025-12-06 first attempt at all samples together
2025-12-06 Fix audio sample writer
    [sample_loader.sv, send_wav.py, top_level.sv, traffic_generator.sv]
2025-12-06 fixed visuals for full instruments
    [delay_gen.sv, dry_gen.sv, note_tracker_midi.sv]
2025-12-07 Add UART parameter automation
2026-02-19 Add PCB interface
2026-03-18 Change velocity curve to piecewise linear
2026-04-09 Add compressed audio samples, create KiCad project for new PCB
    [pcb2.kicad_pcb, pcb2.kicad_sch]
2026-04-10 Fix sample mixer
2026-06-07 Implement expression pedal controls
    [pcb2.kicad_pcb, pcb2.kicad_sch]
2026-06-10 Add Ethernet audio interface driver
2026-06-11 Change most logic (except audio effects) to use 48 kHz sample rate. Getting error that xpm_fifo_axis not found...
    [audio_processor.sv, downsampler.sv, dram_read_requester.sv, dram_reader_audio.sv, midi_processor.sv, pedal_controller.sv, pitch_to_sample_period.sv, pot_controller.sv]
2026-06-12 Fix build issues. Now need to fix timing.
    [audio_processor.sv, top_level.sv, top_level.xdc, upsampler.sv]
2026-06-13 Incorporate recording for all instruments and fix timing issues
    [audio_delay.sv, audio_eth_transmit.sv, audio_processor.sv, dac_controller.sv, dram_reader_audio.sv, farrow_upsampler.sv, main.c, sample_scaler.sv]
2026-06-13 Remove unwanted KiCad files
    [pcb2.kicad_pcb, pcb2.kicad_sch]
2026-06-15 Update filter coefficients
2026-06-16 Ethernet driver debugging
2026-06-16 Implement adaptive resampling on FPGA and corresponding (not-yet-tuned) driver code
